vitorcunhap/ball-and-beam-pid/(commit log)

2026-04-21 Add files via upload
    Adiciona código Arduino do controlador PID
2026-04-21 Add files via upload
    Adiciona diagrama de blocos Xcos
